vovchik03/Ultrasonic-Radar/gif/social-preview.jpg

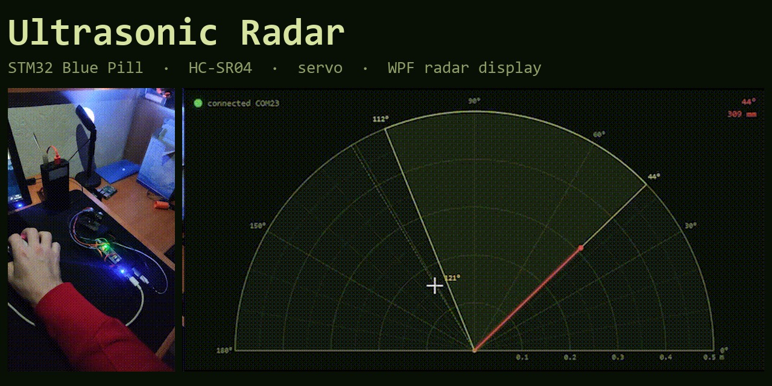
gif/social-preview.jpg
