vovchik03/Ultrasonic-Radar/git gif - radar (small).gif

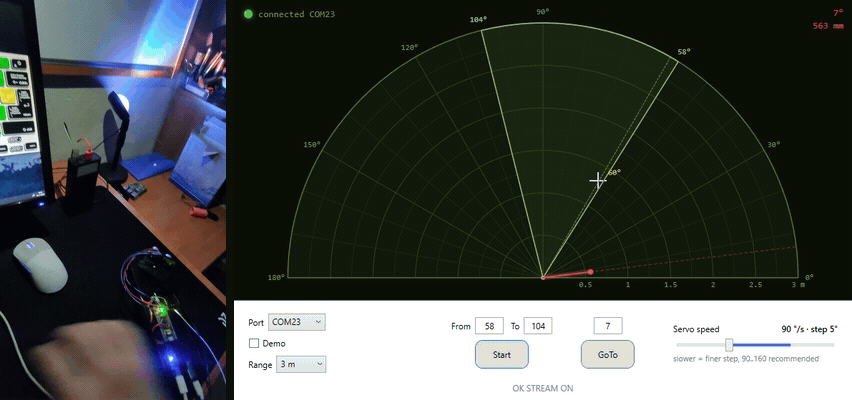
git gif - radar (small).gif
