vovchik03/Ultrasonic-Radar/asembl-ultrasonic.STEP

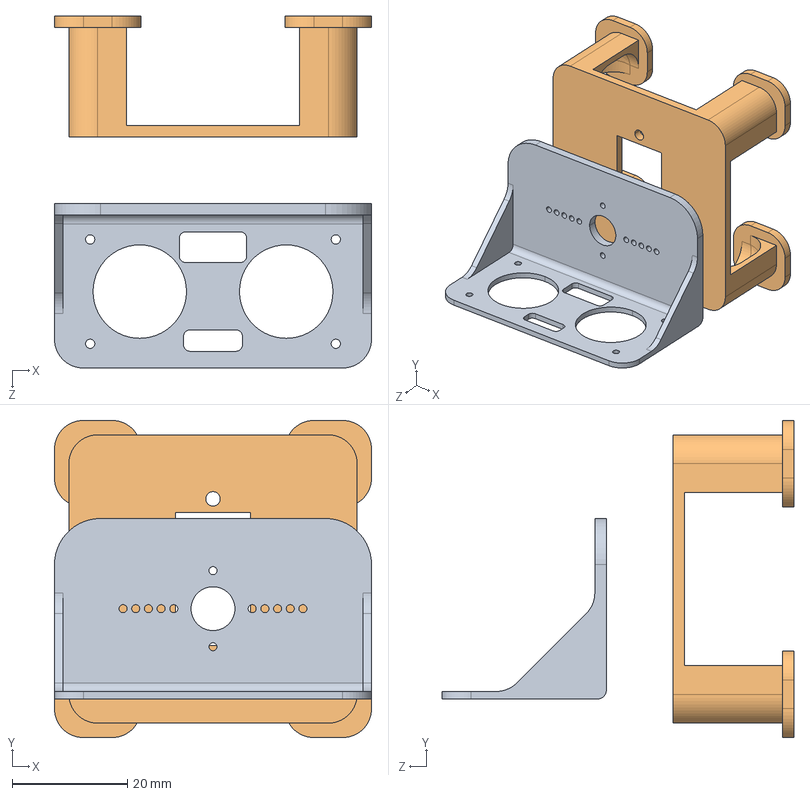
[picture p5: CAD file, 2026-10-01]
asembl-ultrasonic.STEP
55.0 x 55.0 x 61.1 mm
ultrasonic A
ultrasonic B
