vovchik03/Ultrasonic-Radar/CAD/Elements/powerbank.SLDPRT

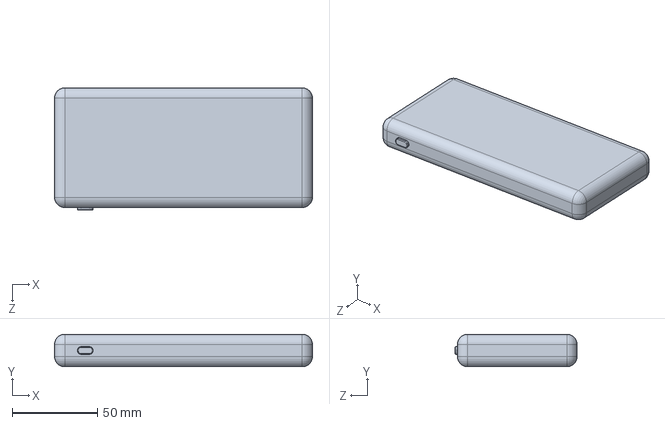
[picture p6: CAD file, 2026-10-22]
CAD/Elements/powerbank.SLDPRT
151.0 x 19.0 x 71.5 mm
