vovchik03/Ultrasonic-Radar/CAD/ultrasonic B.STEP

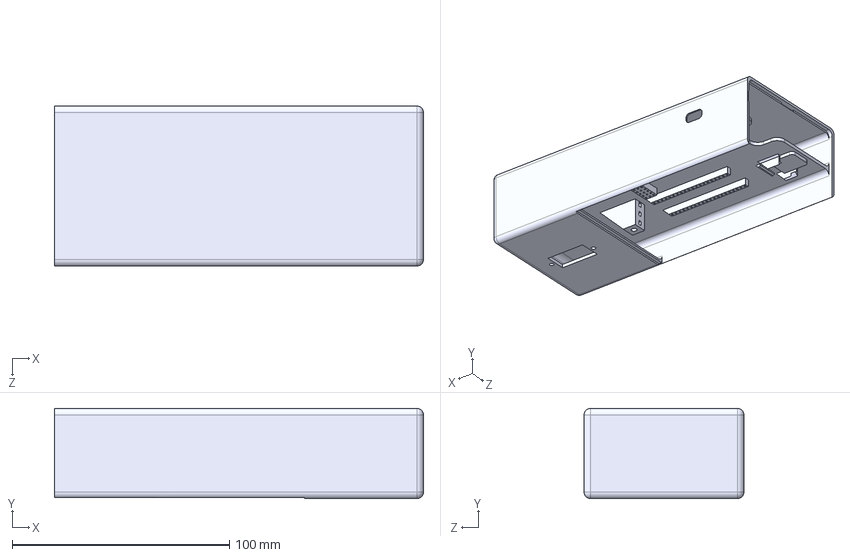
[picture p7: CAD file, 2026-10-22]
CAD/ultrasonic B.STEP
170.0 x 41.5 x 73.7 mm
