vovchik03/Ultrasonic-Radar/CAD/Elements/HW-234.SLDPRT

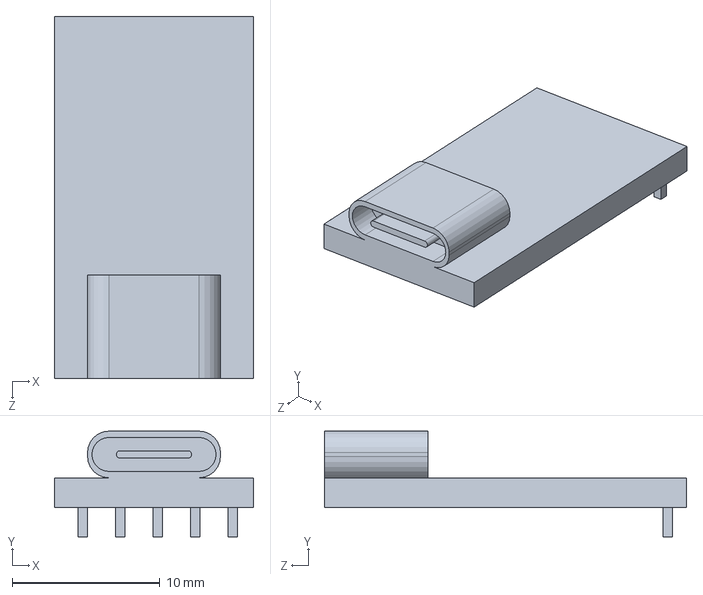
[picture p8: CAD file, 2026-10-22]
CAD/Elements/HW-234.SLDPRT
13.5 x 7.16 x 24.5 mm
