vovchik03/Ultrasonic-Radar/CAD/ultrasonic С.STEP

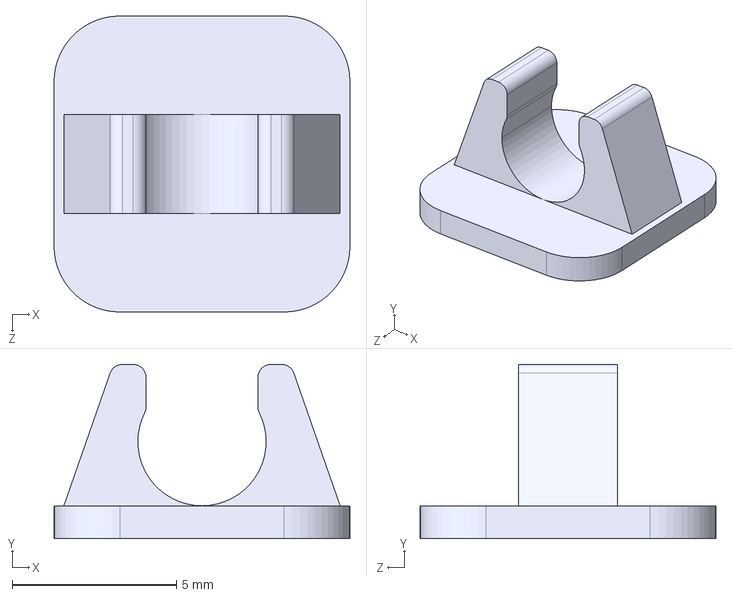
[picture p9: CAD file, 2026-10-22]
CAD/ultrasonic С.STEP
9.00 x 5.30 x 9.00 mm
