vovchik03/Ultrasonic-Radar/CAD/ultrasonic A.STEP

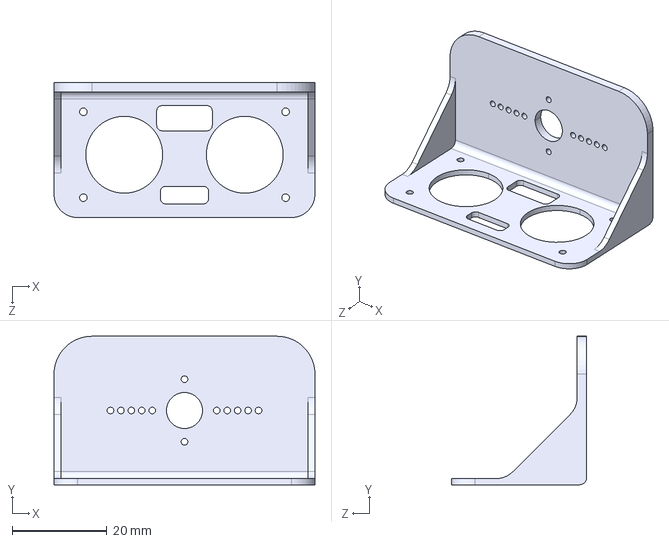
[picture p10: CAD file, 2026-10-01]
CAD/ultrasonic A.STEP
55.0 x 31.3 x 28.5 mm
