vovchik03/Ultrasonic-Radar/CAD/Elements/STM32F103C8T6_Blue_Pill.SLDASM

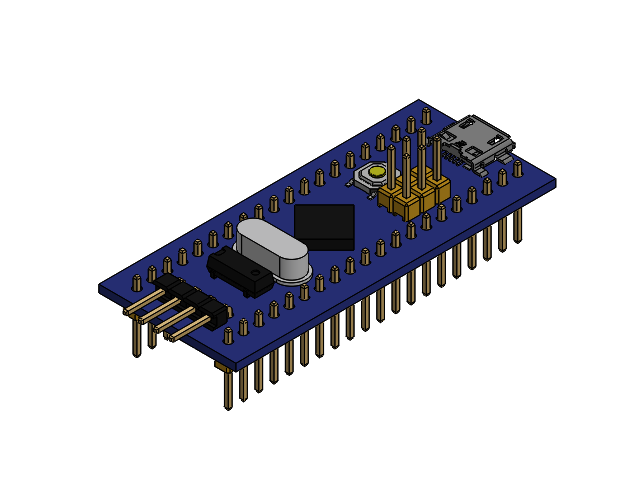
[picture p11: CAD file, 2026-10-20]
CAD/Elements/STM32F103C8T6_Blue_Pill.SLDASM
Oscillator_HC-49_S.step
STM32F103C8T6_BluePill_Board.step
Oscillator_MC-306.step
STM32_LQFP48.step
Tactile_SMD_5x5mm.step
2040343-2.step
Header_L4_10x4.8.step
Header_Male_2x3x11.6.step
Header_Male_1x20x11.6.step x 2
