vovchik03/Ultrasonic-Radar/(list of files, cad)

Other CAD files:
CAD/asembl-ultrasonic.SLDASM
CAD/ultrasonic B.SLDPRT
CAD/ultrasonic С.SLDPRT
asembl-ultrasonic.SLDASM
ultrasonic A.SLDPRT
ultrasonic B.SLDPRT
