vovchik03/Ultrasonic-Radar/setup.md

# Ultrasonic radar — setup

## Склад

- **STM32F103C8T6** (плата Blue Pill), тактування 64 МГц від внутрішнього генератора HSI (кварц 8 МГц на платі не стартує)
- **HC-SR04** — ультразвуковий далекомір, живлення 5 В
- **Сервопривод SG90 / MG90S** — повертає датчик, живлення 5 В
- **USB-UART адаптер** (CP2102 / CH340 / FT232, логіка 3.3 В) — зв'язок з ПК
- **ST-Link** — прошивка і налагодження по SWD

## Логіка роботи

Радар працює за принципом "крок — вимір":

1. Сервопривод повертає датчик на наступний кут (крок 9°; останній крок до краю сектора коротший, щоб край теж вимірювався).
2. Прошивка чекає, поки серво доїде і датчик перестане хитатися:
   40 мс + 2 мс на кожен пройдений градус. Якщо командою `SPEED` задана
   швидкість, серво йде до кута поступово, градус за градусом, і замість
   2 мс/° береться час руху з цією швидкістю.
3. HC-SR04 робить один пінг. Тривалість імпульсу ECHO апаратно вимірює
   TIM4 (захоплення фронту і спаду, роздільність 1 мкс).
4. Відстань записується в таблицю для цього кута (0..180°).
   `0` означає, що відлуння не було (таймаут 50 мс) або об'єкт далі за 4 м.
5. Перехід до наступного кута. На краю сектора серво розвертається
   і йде назад.

Після ввімкнення радар стоїть: серво на 90°, пінгів немає, поки не прийде
команда `SCAN`, `GOTO` або `HOLD`.
`SCAN 0 180` сканує весь сектор (21 точка: 0, 9, ... 180).
Командами `GOTO` і `HOLD` можна навести промінь на один кут і міряти лише його.

### Частота опитування HC-SR04

Час на одну точку:

```
T = max(70 мс, settle + t_echo)
settle = 40 мс + max(2 мс × Δ, 1000 × Δ / SPEED)    Δ = крок, 9°
t_echo ≈ 0.5 мс + 5.83 мс × d[м]                    звук туди й назад, 343 м/с
```

70 мс — мінімальна пауза між пінгами (`ULTRASONIC_PERIOD_MS`). Даташит
HC-SR04 вимагає ≥ 60 мс; 70 мс дають запас і рівну частоту 14.3 Гц.
Якщо відлуння немає, ECHO тримається ~38 мс, у гіршому разі спрацьовує
таймаут 50 мс.

Без обмеження швидкості (`SPEED 0`, після ввімкнення): settle = 40 + 2 × 9 = 58 мс.

| Відстань | t_echo | Час на точку | Частота | Прохід 0..180 (20 кроків) |
|---|---|---|---|---|
| до ~2 м | ≤ 12 мс | 70 мс | 14.3 Гц | 1.4 с |
| 3 м | 18 мс | 76 мс | 13.2 Гц | 1.5 с |
| 4 м | 23.8 мс | 82 мс | 12.2 Гц | 1.6 с |
| немає відлуння | 38..50 мс | 96..108 мс | 9.3..10.4 Гц | 1.9..2.2 с |

`GOTO`/`HOLD` на місці (кут не змінюється, settle = 40 мс): 70 мс на точку
(14.3 Гц) на всю дальність до 4 м, без відлуння — 78..90 мс.

### Швидкість серво (`SPEED`)

Об'єкт на 1 м:

| `SPEED` | Рух на 9° | Час на точку | Частота | Прохід 0..180 |
|---|---|---|---|---|
| 0 або 500 | 18 мс | 70 мс | 14.3 Гц | 1.4 с |
| 180 | 50 мс | 96 мс | 10.4 Гц | 1.9 с |
| 90 | 100 мс | 146 мс | 6.8 Гц | 2.9 с |
| 45 | 200 мс | 246 мс | 4.1 Гц | 4.9 с |
| 20 | 450 мс | 496 мс | 2.0 Гц | 9.9 с |

Швидше ~380 °/с рух ховається в 70 мс між пінгами, і частота вже не росте.

**Рекомендовано `SPEED 90`..`180`:** серво рухається плавно, піки струму
значно менші, ніж при ривку на повній швидкості (менше просідає 5 В, менше
хибних відлунь), а прохід 0..180 усе ще коротший за 3 с. Нижче ~45 °/с
картинка оновлюється надто повільно (> 5 с на прохід). `SPEED 0` — найшвидше
сканування, але серво смикається на кожному кроці.

Головний цикл неблокуючий: читає команди з UART, крутить автомат
сканування і керує світлодіодом. Виняток — відправка по UART: вона йде з
очікуванням, відповідь на `GET` (весь сектор 0..180) займає ~17 мс.

**Світлодіод PC13:** блимає (перемикається кожні 500 мс), а якщо об'єкт
ближче 200 мм — горить постійно.

### Команди (USART1, 115200 8N1)

Команди текстові, по одній на рядок (закінчення CR і/або LF), регістр не важливий.
Рядок до 31 символу, довші обрізаються.

| Команда | Дія | Відповідь |
|---|---|---|
| `SCAN <from> <to>` | сканувати сектор, кути 0..180, порядок не важливий, роздільник пробіл, `-` або `,` (`SCAN 40-70`) | `OK SCAN 40 70` |
| `GOTO <angle>` | дійти від поточного кута до `<angle>` кроками SCAN, міряючи дорогою, потім стояти й міряти цей кут | `OK GOTO 120` |
| `HOLD <angle>` | одразу повернутися на `<angle>` без замірів дорогою, потім стояти й міряти цей кут | `OK HOLD 120` |
| `SPEED <deg/s>` | швидкість серво для `SCAN`, `GOTO` і `HOLD`: 1..500 °/с, `0` = без обмеження (після ввімкнення); діє з наступного кроку | `OK SPEED 90` |
| `STEP <deg>` | крок сітки для `SCAN` і `GOTO`: 1..30°, 9 після ввімкнення; діє з наступного кроку | `OK STEP 5` |
| `STOP` | зупинити сканування, серво тримає кут | `OK STOP` |
| `GET` | відстані поточного сектора на сітці `STEP`, пари `кут:мм` | `DATA 40:523 49:518 58:0 67:1180 70:1210` (після `SCAN 40 70`, крок 9°) |
| `STREAM ON\|OFF` | надсилати кожну нову точку одразу | `OK STREAM ON`, далі `P 45 523` |

`GOTO` і `HOLD` після приїзду міряють один кут безкінечно. З `STREAM ON`
приходить безперервний потік рядків `P 120 <мм>`. Режим скасовує наступна `SCAN`,
`GOTO`, `HOLD` або `STOP`.

Різниця між `GOTO` і `HOLD` — що відбувається дорогою і що потім покаже `GET`:

| | `GOTO 120` | `HOLD 120` |
|---|---|---|
| Рух | кроками `STEP` (9° після ввімкнення), з паузою і пінгом на кожному кроці | одним рухом, зі швидкістю `SPEED` (за замовчуванням — максимальна швидкість серво) |
| Заміри дорогою | так, `P` на кожному кроці | ні, перший `P` вже на 120° |
| `GET` | весь пройдений сектор [поточний..120] | лише `120:мм` |

Як і `SCAN`, обидві команди очищують таблицю відстаней.

Помилки: `ERR UNKNOWN`, `ERR ARGS` (неправильний формат, зокрема число довше 3 цифр),
`ERR RANGE` (кут > 180, швидкість > 500, крок не 1..30).

Додаток надсилає `STEP` разом із `SPEED`: крок = кут, який серво проходить
за 50 мс, округлений і обмежений 2..8° (30 °/с → 2°, 90 °/с → 5°, від 160 °/с → 8°).
У діапазоні ~40..160 °/с кожен рух триває ~50 мс, точки йдуть з частотою ~10 Гц,
а повільніше серво дає густішу сітку. Вище 160 °/с крок лишається 8°, рух
коротшає і точки йдуть частіше; нижче 40 °/с крок лишається 2° і рух довшає.
Повний опис — у [cmd.h](STM32F103C8Tx_Radar/Core/Inc/cmd.h).

## Підключення

Схематично те саме показано в KiCad — [PCB/ultrasonic.kicad_sch](PCB/ultrasonic.kicad_sch):
які вузли Blue Pill використовуються і як до них під'єднані HC-SR04, серво,
USB-UART і живлення від powerbank.

### HC-SR04

| HC-SR04 | Blue Pill | Примітка |
|---|---|---|
| VCC | 5V | |
| TRIG | PB7 | вихід, імпульс 12 мкс |
| ECHO | PB6 | TIM4_CH1; пін 5 В-толерантний (FT), тому 5 В з датчика можна подавати напряму |
| GND | GND | |

### Сервопривод

| Сервопривод | Blue Pill | Примітка |
|---|---|---|
| Сигнал (помаранчевий / жовтий) | PA0 | TIM2_CH1, ШІМ 50 Гц, 500..2500 мкс = 0..180° |
| V+ (червоний) | 5V | краще окреме джерело 5 В (див. "Живлення") |
| GND (коричневий / чорний) | GND | |

### USB-UART адаптер

| Адаптер | Blue Pill | Примітка |
|---|---|---|
| RX | PA9 (USART1_TX) | |
| TX | PA10 (USART1_RX) | вхід із підтяжкою вгору |
| GND | GND | |

Лінії перехрещуються: TX однієї сторони йде на RX іншої.

### ST-Link (SWD)

| ST-Link | Blue Pill |
|---|---|
| SWDIO | PA13 (DIO) |
| SWCLK | PA14 (CLK) |
| GND | GND |
| 3.3V | 3.3 (лише якщо плата не живиться від USB або 5V) |

### Зайняті піни (не використовувати як GPIO)

| Пін | Призначення |
|---|---|
| PC13 | світлодіод на платі (вмикається низьким рівнем) |
| PA13, PA14 | SWD |
| PD0, PD1 | кварц 8 МГц (зараз не використовується, але припаяний до цих пінів) |
| PA11, PA12 | USB D− / D+ на micro-USB плати (не використовується; на PA12 підтяжка до 3.3 В) |

Карта пінів у коді — [main.h](STM32F103C8Tx_Radar/Core/Inc/main.h).

## Живлення

- HC-SR04 і сервопривод живляться від 5 В, мікроконтролер — від 3.3 В
  (стабілізатор на Blue Pill).
- Сервопривод під час руху споживає імпульси струму до ~0.7 А. Від USB
  через Blue Pill його краще не живити: просідання 5 В скидає МК і дає
  хибні відлуння на HC-SR04. Краще окреме джерело 5 В / ≥1 А.
- **Усі GND з'єднані між собою** (Blue Pill, датчик, серво, адаптер,
  джерело серво). Без спільної землі сигнали PA0 / PB6 / PB7 не працюють.
- Якщо серво живиться від окремого джерела, а Blue Pill — від USB,
  не з'єднуйте їхні лінії 5V між собою — тільки GND.
