vovchik03/Ultrasonic-Radar/PCB/ultrasonic.kicad_sch

## KiCad design PCB/ultrasonic.kicad_sch (2026-10-23)

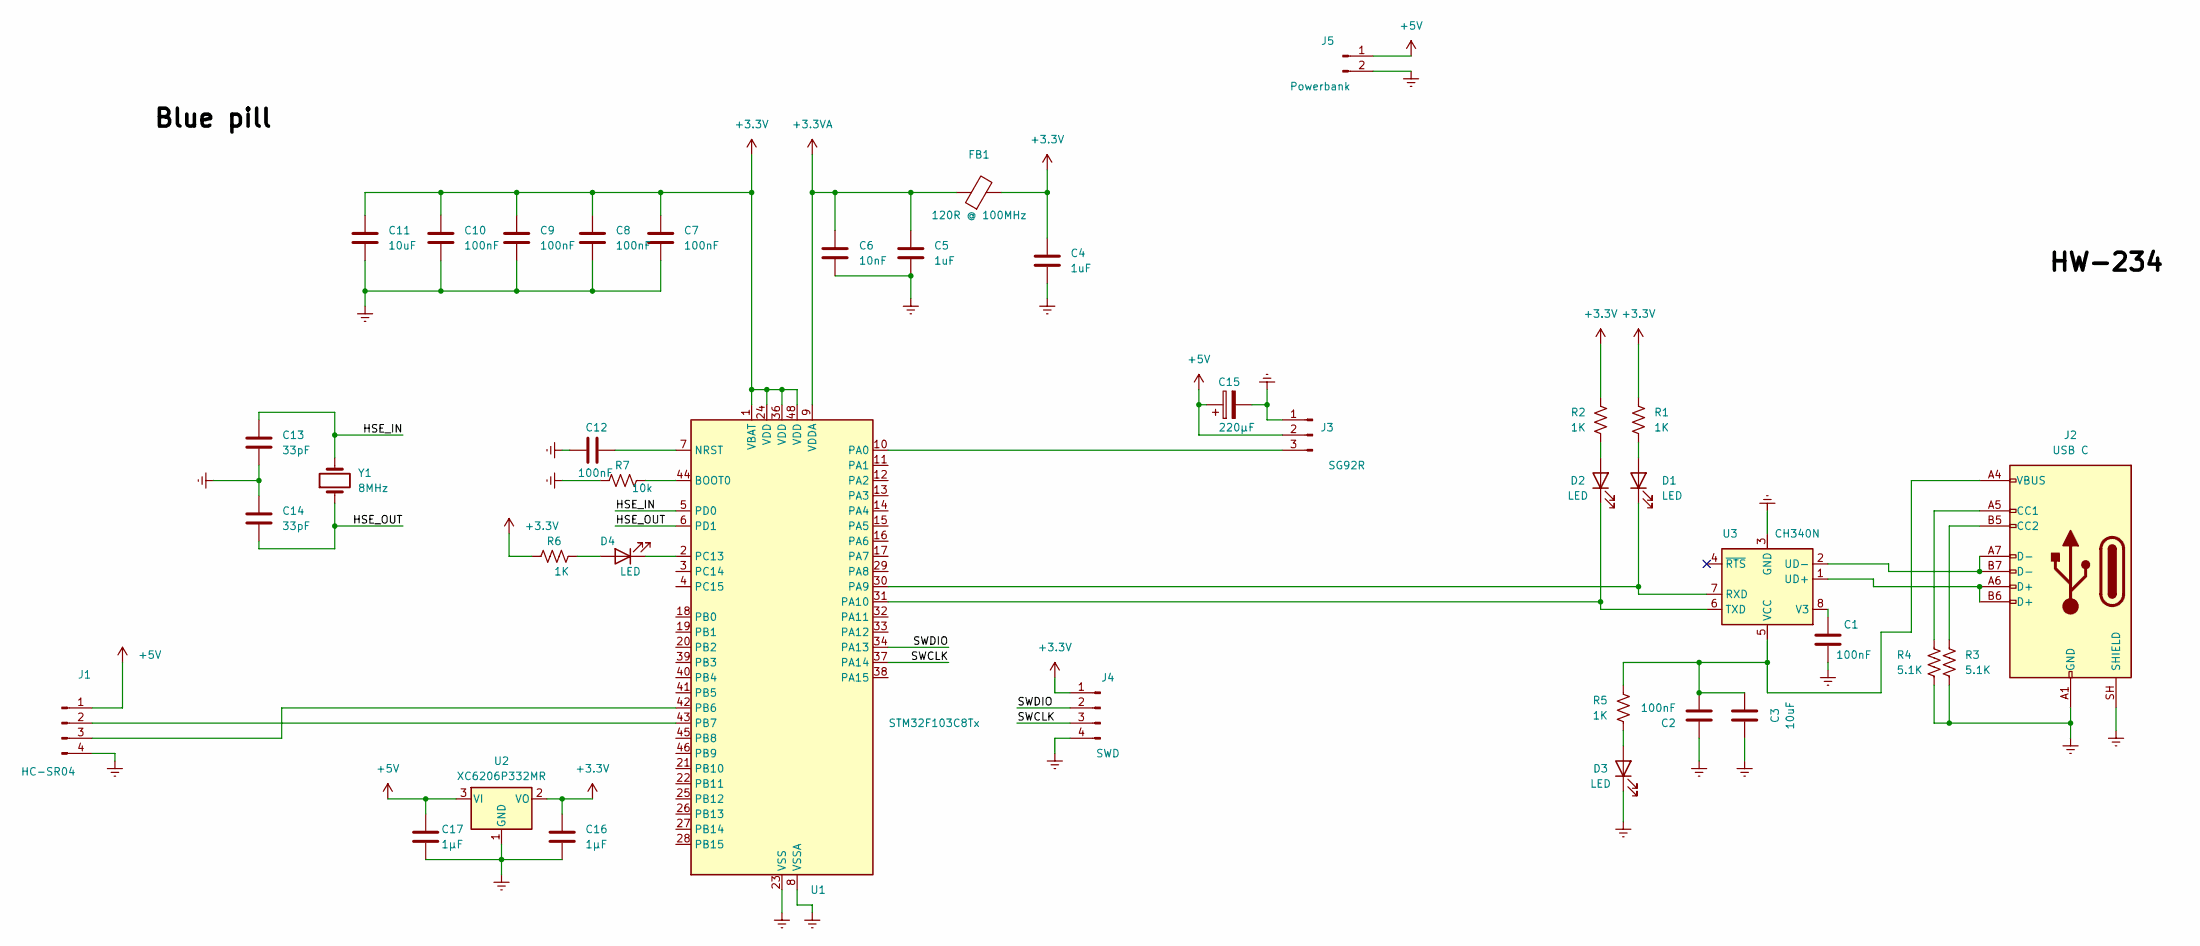
[picture p12: schematic ultrasonic.kicad_sch]

Parts:
C1, C2, C7, C8, C9, C10, C12: 100nF
C3, C11: 10uF
C4, C5: 1uF
C6: 10nF
C13, C14: 33pF
C15: 220µF
C16, C17: 1µF
D1, D2, D3, D4: LED
FB1: 120R @ 100MHz
J1: HC-SR04
J2: USB C
J3: SG92R
J4: SWD
J5: Powerbank
R1, R2, R5, R6: 1K; R_0805_2012Metric
R3, R4: 5.1K; R_0805_2012Metric
R7: 10k; R_0805_2012Metric
U1: STM32F103C8Tx; LQFP-48_7x7mm_P0.5mm
U2: XC6206P332MR; SOT-23-3
U3: CH340N; JEITA_SOIC-8_3.9x4.9mm_P1.27mm
Y1: 8MHz

Connections:
+3.3V: C4.1, C7.1, C8.1, C9.1, C10.1, C11.1, C16.2, FB1.2, J4.1, R1.1, R2.1, R6.1, U1.1 (VBAT), U1.24 (VDD), U1.36 (VDD), U1.48 (VDD), U2.2 (VO)
+3.3VA: C5.1, C6.1, FB1.1, U1.9 (VDDA)
+5V: C15.1, C17.2, J1.1, J3.2, J5.1, U2.3 (VI)
HSE_IN: C13.1, U1.5 (PD0), Y1.2
HSE_OUT: C14.2, U1.6 (PD1), Y1.1
unnamed: C1.1, U3.8 (V3)
unnamed: C1.2, C2.2, C3.2, C4.2, C5.2, C6.2, C7.2, C8.2, C9.2, C10.2, C11.2, C12.2, C13.2, C14.1, C15.2, C16.1, C17.1, D3.1 (K), J1.4, J2.A1 (GND), J2.A12 (GND), J2.B1 (GND), J2.B12 (GND), J2.SH (SHIELD), J3.1, J4.4, J5.2, R3.2, R4.2, R7.1, U1.8 (VSSA), U1.23 (VSS), U1.35 (VSS), U1.47 (VSS), U2.1 (GND), U3.3 (GND)
unnamed: C2.1, C3.1, J2.A4 (VBUS), J2.A9 (VBUS), J2.B4 (VBUS), J2.B9 (VBUS), R5.2, U3.5 (VCC)
unnamed: C12.1, U1.7 (NRST)
unnamed: D1.1 (K), U1.30 (PA9), U3.7 (RXD)
unnamed: D1.2 (A), R1.2
unnamed: D2.1 (K), U1.31 (PA10), U3.6 (TXD)
unnamed: D2.2 (A), R2.2
unnamed: D3.2 (A), R5.1
unnamed: D4.1 (K), U1.2 (PC13)
unnamed: D4.2 (A), R6.2
unnamed: J1.2, U1.43 (PB7)
unnamed: J1.3, U1.42 (PB6)
unnamed: J2.A5 (CC1), R4.1
unnamed: J2.A6 (D+), J2.B6 (D+), U3.1 (UD+)
unnamed: J2.A7 (D-), J2.B7 (D-), U3.2 (UD-)
unnamed: J2.B5 (CC2), R3.1
unnamed: J3.3, U1.10 (PA0)
unnamed: R7.2, U1.44 (BOOT0)
SWCLK: J4.3, U1.37 (PA14)
SWDIO: J4.2, U1.34 (PA13)
