vovchik03/Ultrasonic-Radar/STM32F103C8Tx_Radar/Core/Src/main.c

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
/* Includes ------------------------------------------------------------------*/
#include "main.h"

/* USER CODE BEGIN Includes */
#include "servo.h"
#include "ultrasonic.h"
#include "scan.h"
#include "uart.h"
#include "cmd.h"
/* USER CODE END Includes */

/* USER CODE BEGIN PD */
#define LED_BLINK_MS          500U
#define RADAR_NEAR_MM         200U    /* demo: LED stays on if an object is closer */
#define CMD_UART_BAUD         115200U
/* USER CODE END PD */


/* USER CODE BEGIN PV */
/* Last measurement, watch it in the debugger (Live Watch) */
volatile uint8_t  radar_angle;
volatile uint16_t radar_distance_mm;
volatile uint8_t  radar_status = ULTRASONIC_NOT_READY;   /* LED blinks until the first point */
/* USER CODE END PV */

void SystemClock_Config(void);
static void MX_GPIO_Init(void);
/**
  * @brief  The application entry point.
  * @retval int
  */
int main(void)
{

  /* MCU Configuration--------------------------------------------------------*/

  /* Reset of all peripherals, Initializes the Flash interface and the Systick. */
  HAL_Init();

  /* Configure the system clock */
  SystemClock_Config();

  /* Initialize all configured peripherals */
  MX_GPIO_Init();
  /* USER CODE BEGIN 2 */
  Servo_Init(SERVO_MODE_180);
  Ultrasonic_Init();
  Scan_Init();                /* idle at the center, waits for a command */
  Uart_Init(CMD_UART_BAUD);

  uint32_t led_tick = HAL_GetTick();
  /* USER CODE END 2 */

  /* Infinite loop */
  /* USER CODE BEGIN WHILE */
  while (1)
  {
    /* USER CODE END WHILE */

    /* USER CODE BEGIN 3 */
    const char *line = Uart_ReadLine();
    if (line != NULL)
    {
      Cmd_Process(line, Uart_Write);
    }

    if (Scan_Update())
    {
      radar_angle = Scan_GetLastAngle();
      radar_distance_mm = Ultrasonic_GetDistanceMm();
      radar_status = Ultrasonic_GetStatus();
      Cmd_ReportPoint(radar_angle, Scan_GetDistanceMm(radar_angle), Uart_Write);
    }

    if ((radar_status == ULTRASONIC_OK) && (radar_distance_mm < RADAR_NEAR_MM))
    {
      HAL_GPIO_WritePin(LED_GPIO_Port, LED_Pin, GPIO_PIN_RESET);  /* LED on (active low) */
    }
    else if ((HAL_GetTick() - led_tick) >= LED_BLINK_MS)
    {
      led_tick = HAL_GetTick();
      HAL_GPIO_TogglePin(LED_GPIO_Port, LED_Pin);
    }
  }
  /* USER CODE END 3 */
}

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
