vovchik03/Ultrasonic-Radar/STM32F103C8Tx_Radar/Core/Inc/main.h

#define LED_Pin GPIO_PIN_13
#define LED_GPIO_Port GPIOC
#define SERVO_PWM_Pin           GPIO_PIN_0    /* PA0, TIM2_CH1, alternate function push-pull */
#define SERVO_PWM_GPIO_Port     GPIOA
#define US_TRIG_Pin             GPIO_PIN_7    /* PB7, push-pull output, idle low */
#define US_TRIG_GPIO_Port       GPIOB
#define US_ECHO_Pin             GPIO_PIN_6    /* PB6, TIM4_CH1 input capture, pull-down */
#define US_ECHO_GPIO_Port       GPIOB
#define UART_TX_Pin             GPIO_PIN_9    /* PA9, USART1_TX, alternate function push-pull */
#define UART_TX_GPIO_Port       GPIOA
#define UART_RX_Pin             GPIO_PIN_10   /* PA10, USART1_RX, input with pull-up */
#define UART_RX_GPIO_Port       GPIOA
