vovchik03/Ultrasonic-Radar/STM32F103C8Tx_Radar/Core/Inc/cmd.h

/**
  ******************************************************************************
  * @file           : cmd.h
  * @brief          : Text command handler for the radar.
  *                   Does not depend on the transport: takes one line and
  *                   writes the reply through the given function, so the
  *                   handler is not tied to UART.
  *
  *  After power-up the radar is idle: the servo holds 90 deg, no pings
  *  until SCAN, GOTO or HOLD.
  *
  *  Commands (case-insensitive, one per line, CR and/or LF terminated):
  *
  *    SCAN <from> <to>   sweep the sector, angles 0..180, order does not
  *                       matter, separator: space, '-' or ','
  *                       e.g. "SCAN 40 70", "scan 40-70"
  *                       -> OK SCAN 40 70
  *    GOTO <angle>       move from the current angle to <angle> (0..180)
  *                       at the SCAN pace, measuring on the way, then hold
  *                       there and keep measuring that angle; GET reports
  *                       the sector [current..angle]
  *                       e.g. "GOTO 120"
  *                       -> OK GOTO 120
  *    HOLD <angle>       turn straight to <angle> (0..180), no measurements
  *                       on the way, then keep measuring that angle;
  *                       GET reports only <angle>
  *                       e.g. "HOLD 120"
  *                       -> OK HOLD 120
  *    SPEED <deg/s>      servo speed for SCAN, GOTO and HOLD moves,
  *                       1..500 deg/s, 0 = no limit (after power-up);
  *                       applies from the next step. Recommended 90..180:
  *                       smooth motion, sweep 0..180 in 1.9..2.9 s
  *                       (0: 1.4 s but the servo jerks), see scan.h
  *                       e.g. "SPEED 90"
  *                       -> OK SPEED 90
  *    STEP <deg>         grid step for SCAN and GOTO, 1..30 deg, 9 after
  *                       power-up; applies from the next step. Smaller =
  *                       denser picture but more points per sweep
  *                       e.g. "STEP 5"
  *                       -> OK STEP 5
  *    STOP               stop sweeping, servo holds its angle
  *                       -> OK STOP
  *    GET                distances of the current sector, "angle:mm" pairs,
  *                       0 = no echo / not measured yet
  *                       on the STEP grid, e.g. after "SCAN 40 70", step 9:
  *                       -> DATA 40:523 49:518 58:0 67:1180 70:1210
  *    STREAM ON|OFF      send every new point as soon as it is measured
  *                       (off after power-up)
  *                       -> OK STREAM ON
  *                       then one line per point, "P <angle> <mm>",
  *                       0 = no echo
  *                       -> P 45 523
  *
  *  Errors: ERR UNKNOWN, ERR ARGS (bad format),
  *          ERR RANGE (angle > 180, speed > 500, step not 1..30)
  ******************************************************************************
  */
#ifndef __CMD_H
#define __CMD_H

#ifdef __cplusplus
extern "C" {
#endif

#include <stdint.h>

typedef void (*Cmd_WriteFn)(const char *s);

/* Execute one command line and send the reply through write() */
void Cmd_Process(const char *line, Cmd_WriteFn write);

/* Call for every newly measured point. Sends "P <angle> <mm>"
   through write() if streaming is on, does nothing otherwise. */
void Cmd_ReportPoint(uint8_t angle, uint16_t distance_mm, Cmd_WriteFn write);

#ifdef __cplusplus
}
#endif

#endif /* __CMD_H */
