vovchik03/Ultrasonic-Radar/STM32F103C8Tx_Radar/Core/Inc/ultrasonic.h

/**
  ******************************************************************************
  * @file           : ultrasonic.h
  * @brief          : HC-SR04 ultrasonic sensor driver.
  *                   TRIG -> PB7 (GPIO output)
  *                   ECHO -> PB6 (TIM4 CH1/CH2 input capture, 5V tolerant pin)
  *                   Auto mode (default): a ping every ULTRASONIC_PERIOD_MS.
  *                   Single-shot mode: a ping only after Ultrasonic_Trigger().
  *                   The echo pulse is timed by hardware with 1 us resolution.
  ******************************************************************************
  */
#ifndef __ULTRASONIC_H
#define __ULTRASONIC_H

#ifdef __cplusplus
extern "C" {
#endif

#include <stdint.h>

/* Minimum time between two pings. HC-SR04 datasheet recommends >= 60 ms,
   otherwise the echo of the previous ping can be taken as the new one.
   70 ms leaves a margin and gives the scanner a steady 14.3 Hz: with the
   default 9 deg step (58 ms settle) every point up to ~2 m takes exactly
   70 ms, see scan.h. */
#define ULTRASONIC_PERIOD_MS          70U

/* No valid echo within this time -> ULTRASONIC_NO_ECHO.
   HC-SR04 holds ECHO high for ~38 ms when nothing is in range. */
#define ULTRASONIC_TIMEOUT_MS         50U

/* Results farther than this are reported as ULTRASONIC_OUT_OF_RANGE */
#define ULTRASONIC_MAX_DISTANCE_MM    4000U

/* Speed of sound, m/s (343 at 20 C) */
#define ULTRASONIC_SOUND_SPEED_MPS    343U

typedef enum
{
  ULTRASONIC_OK = 0,        /* distance is valid                        */
  ULTRASONIC_OUT_OF_RANGE,  /* echo received, but farther than the max  */
  ULTRASONIC_NO_ECHO,       /* sensor did not answer (wiring / timeout) */
  ULTRASONIC_NOT_READY      /* no measurement finished yet              */
} Ultrasonic_Status;

void              Ultrasonic_Init(void);

/* Call from the main loop as often as possible (non-blocking).
   Starts pings (see the modes above) and collects the result.
   Returns 1 when a new result is available, 0 otherwise. */
uint8_t           Ultrasonic_Update(void);

/* 1 = ping every ULTRASONIC_PERIOD_MS (default), 0 = single-shot mode */
void              Ultrasonic_SetAutoMode(uint8_t enable);

/* Single-shot mode: request one ping. It is sent from Ultrasonic_Update()
   as soon as ULTRASONIC_PERIOD_MS has passed since the previous ping. */
void              Ultrasonic_Trigger(void);

/* 1 while a ping is requested or its echo is awaited */
uint8_t           Ultrasonic_IsBusy(void);

Ultrasonic_Status Ultrasonic_GetStatus(void);
uint16_t          Ultrasonic_GetDistanceMm(void);  /* 0 if status != OK */
uint16_t          Ultrasonic_GetEchoUs(void);      /* raw echo pulse width */

#ifdef __cplusplus
}
#endif

#endif /* __ULTRASONIC_H */
