vovchik03/Ultrasonic-Radar/(commit log)

2026-09-21 Delete ultrasonic A.3mf
    not needed at this stage
    [ultrasonic A.3mf]
2026-09-24 Done: VS code though CubeMX project created and simple diode blink test commit ToDo: system design, draft: servo driver, ultrasonic driver, uotput to spi display, and app conection through usb in the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
2026-09-25 servo driver
2026-09-27 ultrasonic triver try 1
2026-10-01 rebuild project on CubeIDE
    [asembl-ultrasonic.SLDASM, asembl-ultrasonic.STEP, ultrasonic A.SLDPRT, ultrasonic A.STEP, ultrasonic B.SLDPRT]
2026-10-12 WPF radar v1.1 real max distance 1800 - 2000 mm
2026-10-18 Done: pcb design ToDo: blue pill copypast quartz and clk dio Fix: servo pins gnd +5v swapped
2026-10-19 PCB: ready, 3.3v will be from blue pill connection to powerbank ToDo: WPF scale from 4m to 2m max range, step case
2026-10-19 WPF max distance now 2000mm
2026-10-20 sch fix CAD work started
2026-10-20 CAD ready for test. ToDo: WPF goto button, fron end can looks good, CAD cap cable testing before add to the project
2026-10-22 yesterday hull tests
2026-10-22 hull test 2
2026-10-23 Tests on prototype, clean up code
2026-10-26 Feature: ultrasonic dps control, servo step control on stm32. ToDo: WPF scroller step and dps control, range selection ux, normal good looking buttons
