vovchik03/Ultrasonic-Radar/(notices)

Notices in the files:
STM32F103C8Tx_Radar/Core/Inc/main.h:
Copyright (c) 2026 STMicroelectronics.
All rights reserved.
This software is licensed under terms that can be found in the LICENSE file
